Surbotaab/uaefiV2/boards/uaefi-e_/board/misc/uaefi-e_-bottom.png

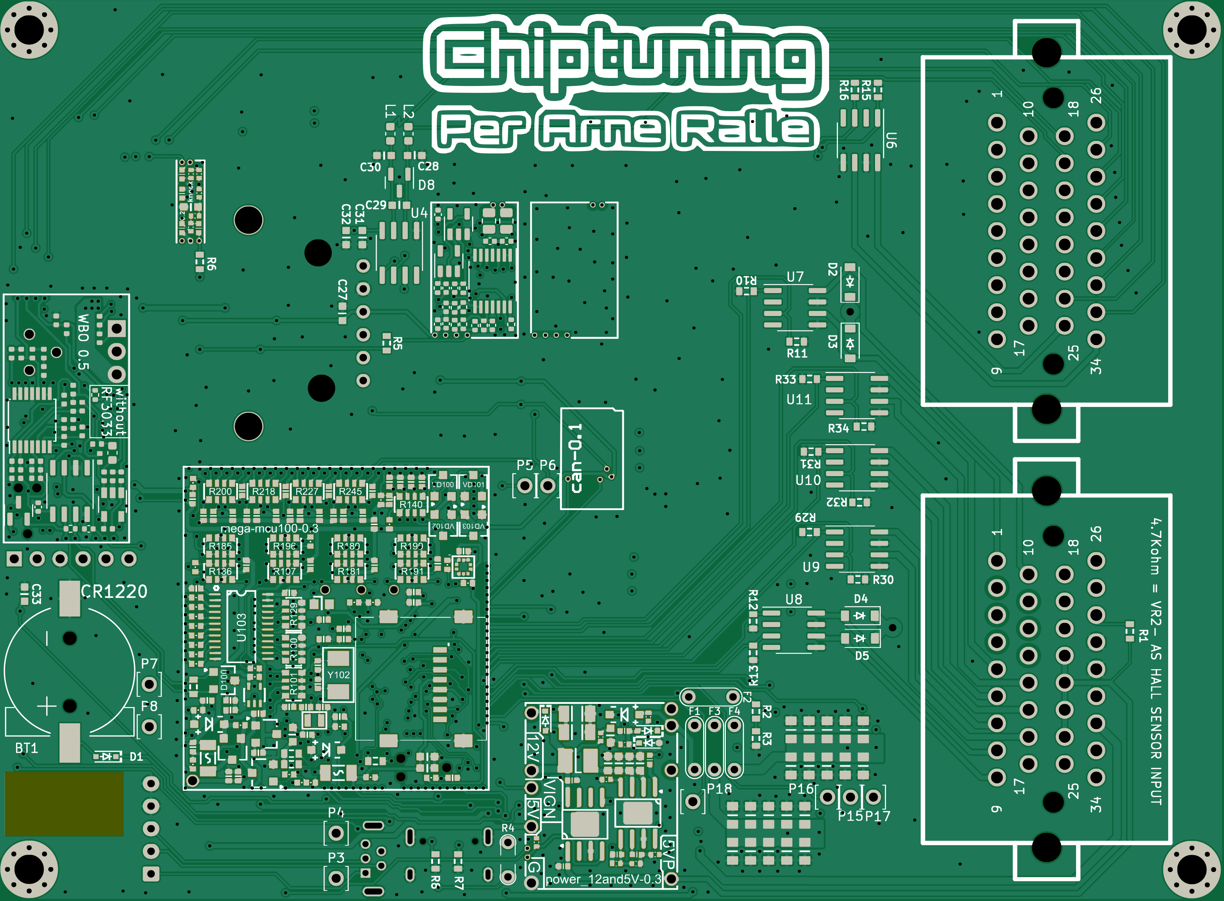
boards/uaefi-e_/board/misc/uaefi-e_-bottom.png
