Surbotaab/uaefiV2/boards/uaefi-e_/board/misc/uaefi-e_-outline.png

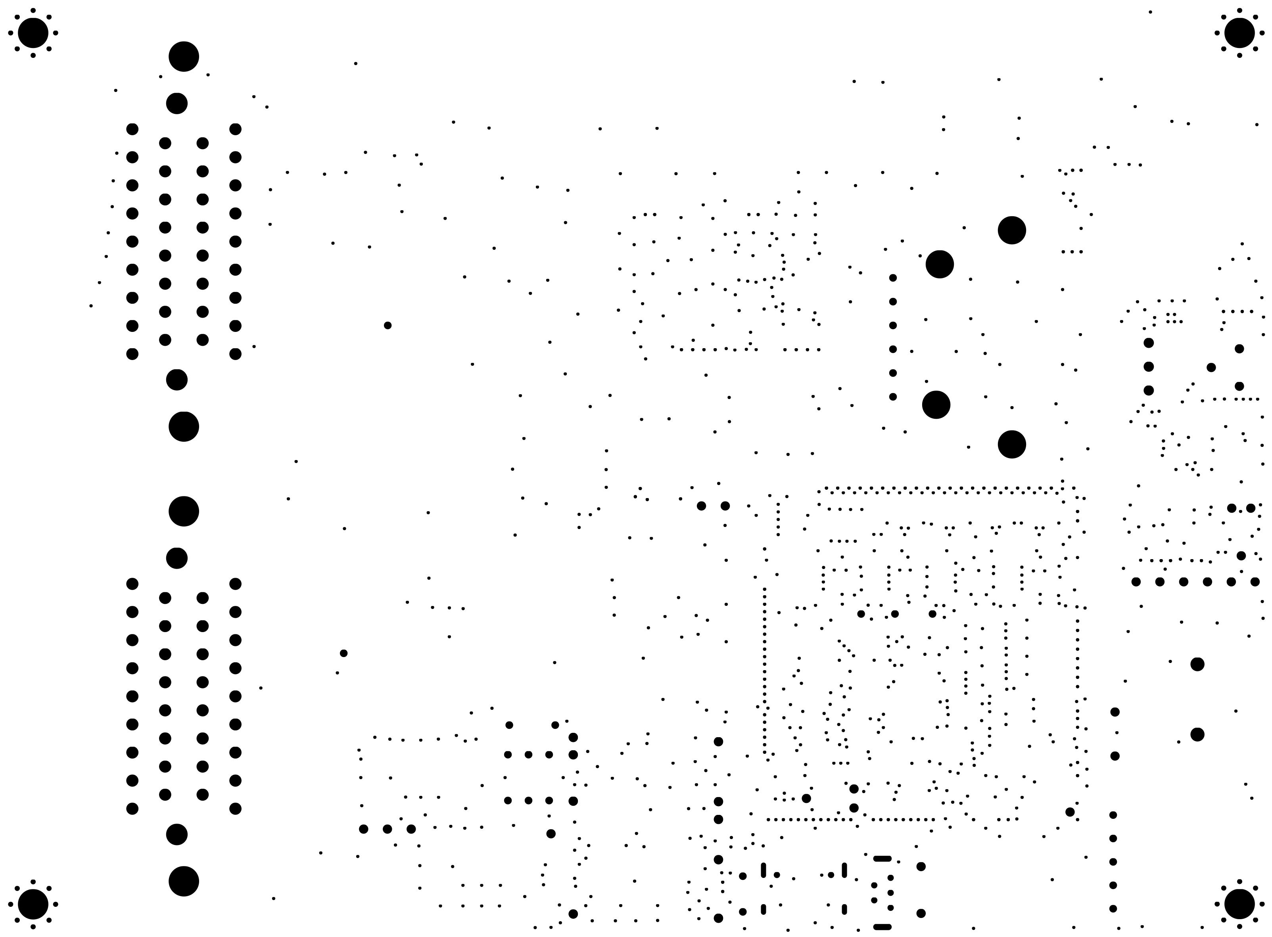
boards/uaefi-e_/board/misc/uaefi-e_-outline.png
