Surbotaab/uaefiV2/boards/uaefi-e_/board/misc/uaefi-e_-top.png

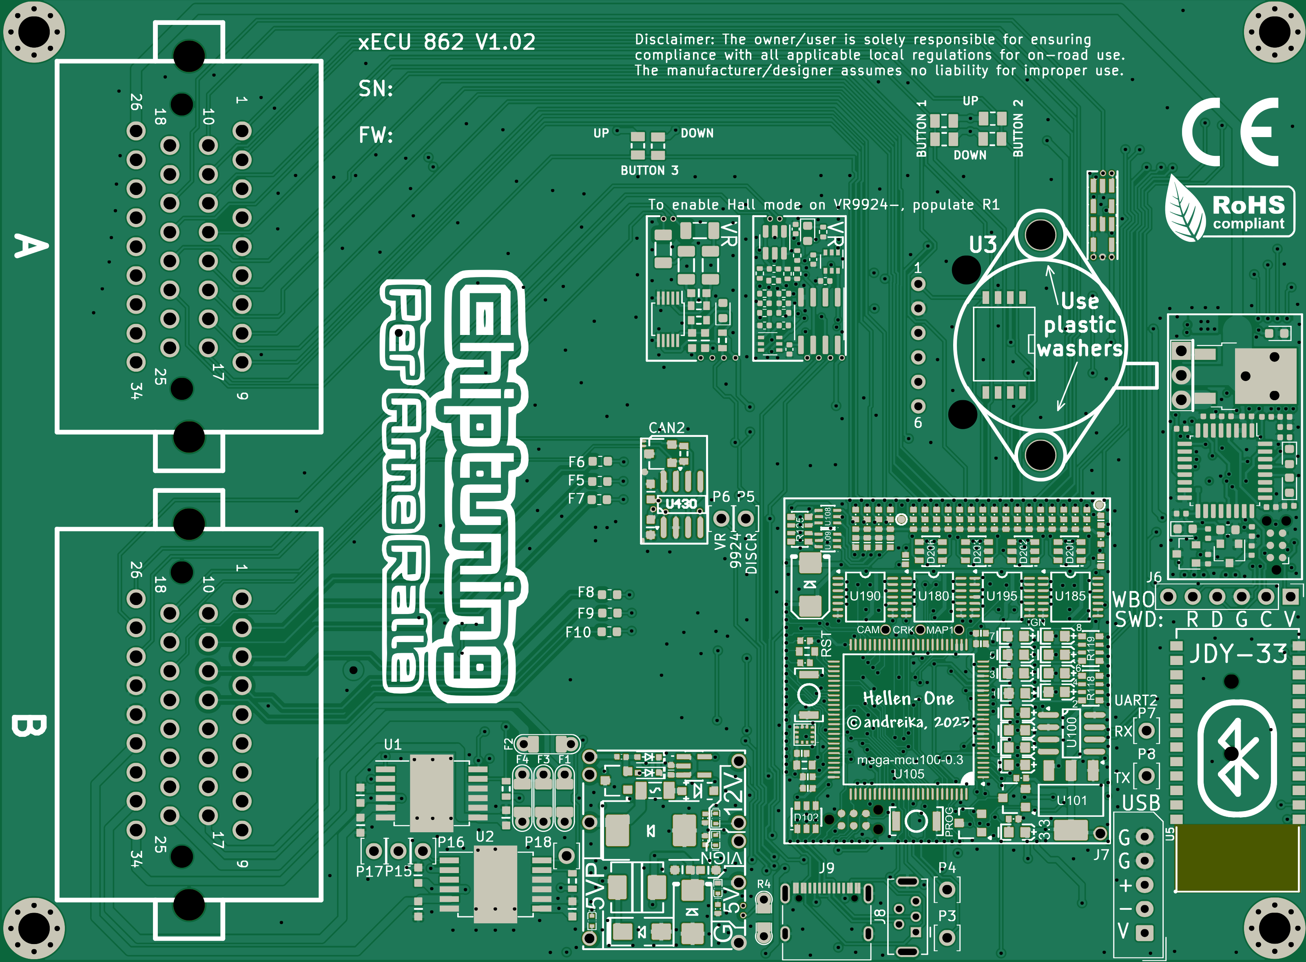
boards/uaefi-e_/board/misc/uaefi-e_-top.png
