Surbotaab/uaefiV2/boards/uaefi-e_/board/uaefi-e_.png

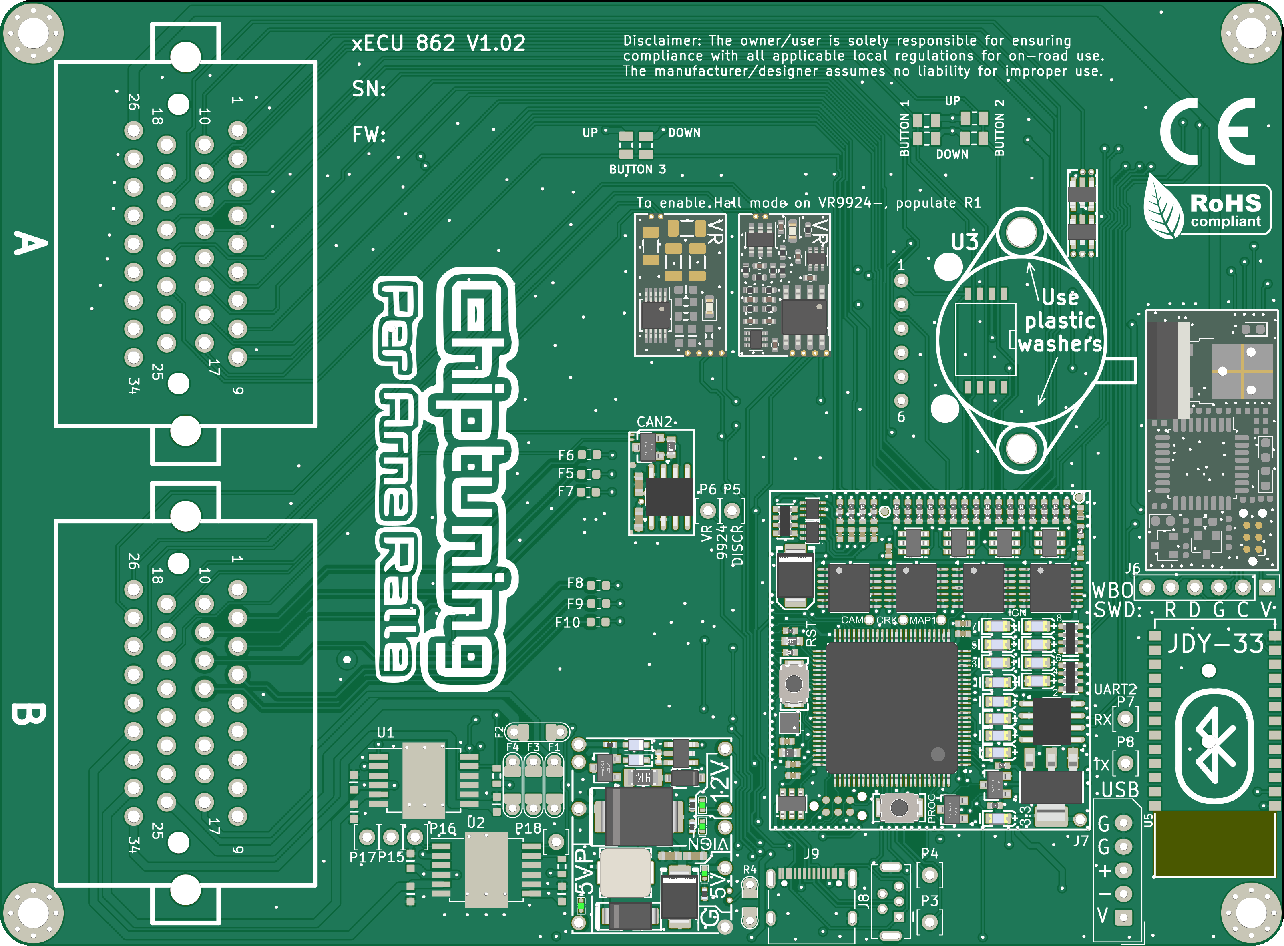
boards/uaefi-e_/board/uaefi-e_.png
