Surbotaab/uaefiV2/boards/uaefi-e_/board/misc/uaefi-e_-components.png

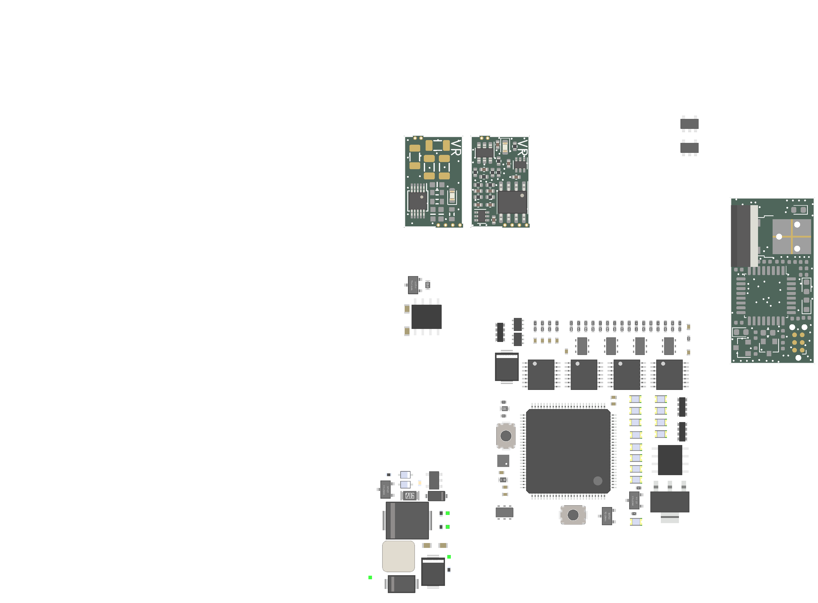
boards/uaefi-e_/board/misc/uaefi-e_-components.png
