Surbotaab/uaefiV2/3D models/2-6447232-3.stp

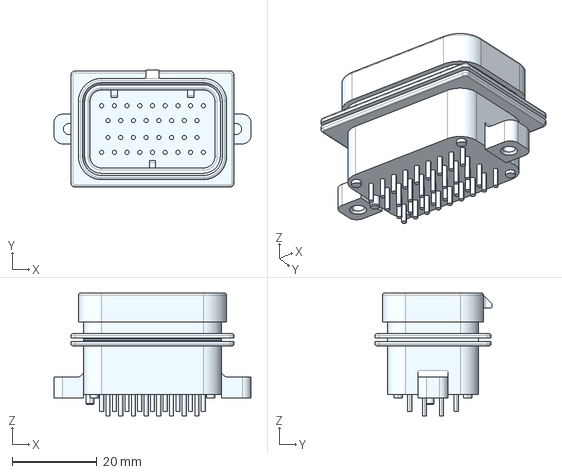
[picture p6: CAD file, 2025-10-13]
3D models/2-6447232-3.stp
46.5 x 27.6 x 29.0 mm
