Surbotaab/uaefiV2/440/uaefiv2.step

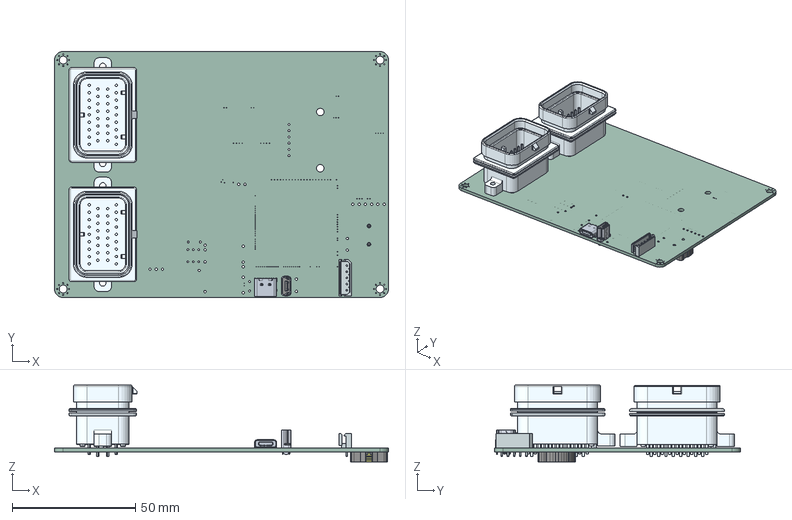
[picture p7: CAD file, 2025-11-03]
440/uaefiv2.step
135.7 x 100.0 x 31.2 mm
C-2-6447232-3 x 2
22035055wbm000_01
B8F5E437-8474-44BC-8B9F-C35146D732A4
u262-16xn-4bvc11_1
CR1220-2
uaefi_PCB
