Surbotaab/uaefiV2/440/changelog.md

# rev E

* power supply fix for RTC
* https://github.com/rusefi/uaefi/issues?q=state%3Aopen%20label%3A%22rev-E%22

# rev D

August 2024

* logic analyzer hookup points for both VRs #66
* minor silkscreen improvements https://github.com/rusefi/uaefi/issues?q=label%3Arev-D+is%3Aclosed

# rev C

Apr 2024

* pad for resistor between VR lines
* a few silkscreen corrections
* full list https://github.com/rusefi/uaefi/issues?q=label%3Arev-C+is%3Aclosed

# rev B

Feb 2024

* [over-current protection on all low side outputs](https://github.com/rusefi/uaefi/issues/44)
* [over-current protection on ignition outputs](https://github.com/rusefi/uaefi/issues/42)
* 0805 button input pull-up/pull-downs added
* button inputs changed from 10K PU to 680K PD https://github.com/rusefi/uaefi/issues/36
* minor cosmetic https://github.com/rusefi/uaefi/labels/rev-B

# rev A

Dec 2023

It works it's great!
