Surbotaab/uaefiV2/uaefi.kicad_pcb

## KiCad design uaefi.kicad_pcb (2026-01-25)

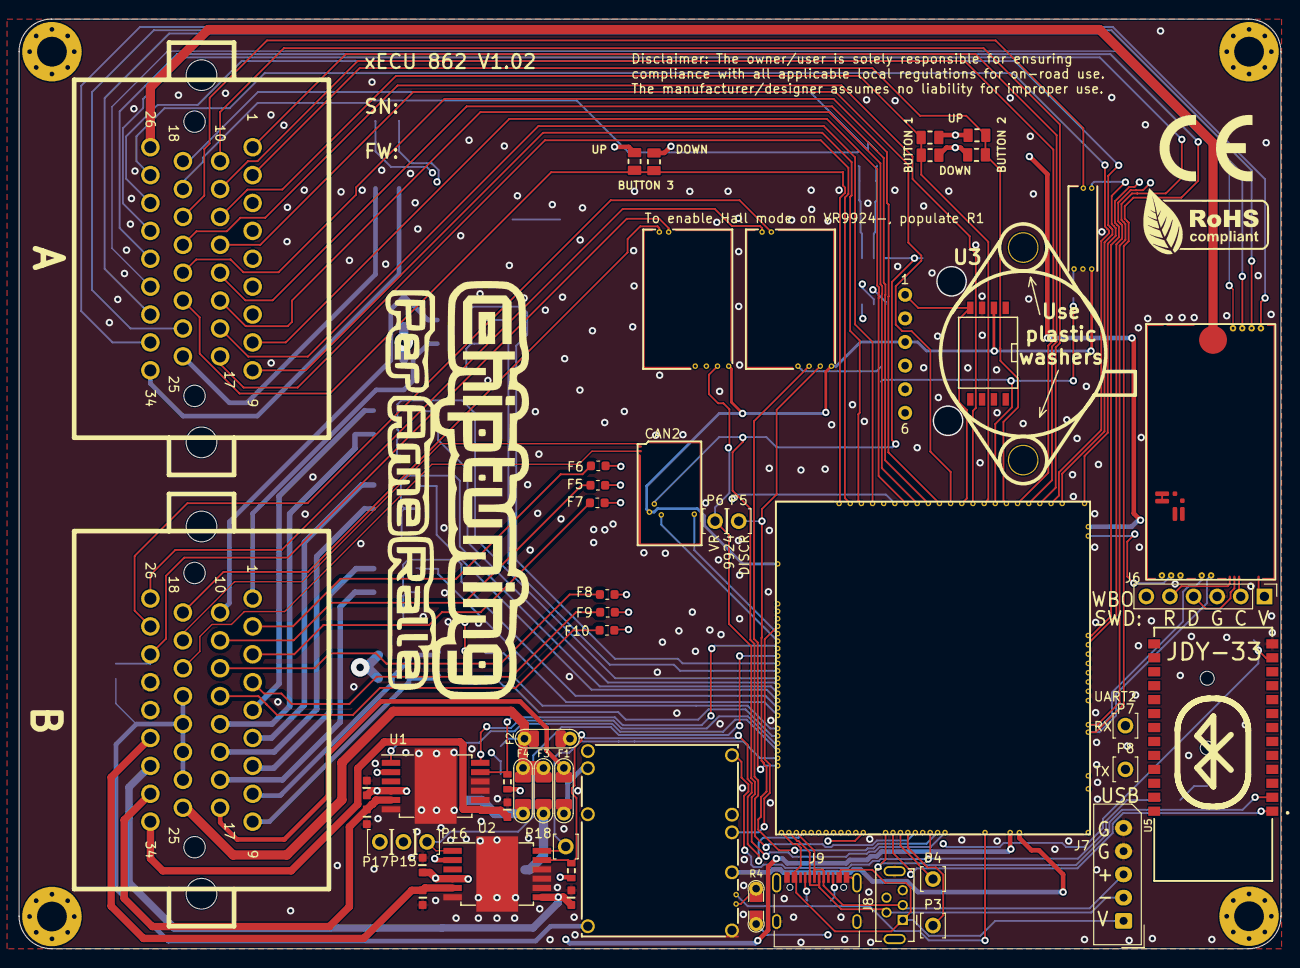
[picture p36: board uaefi.kicad_pcb from above]

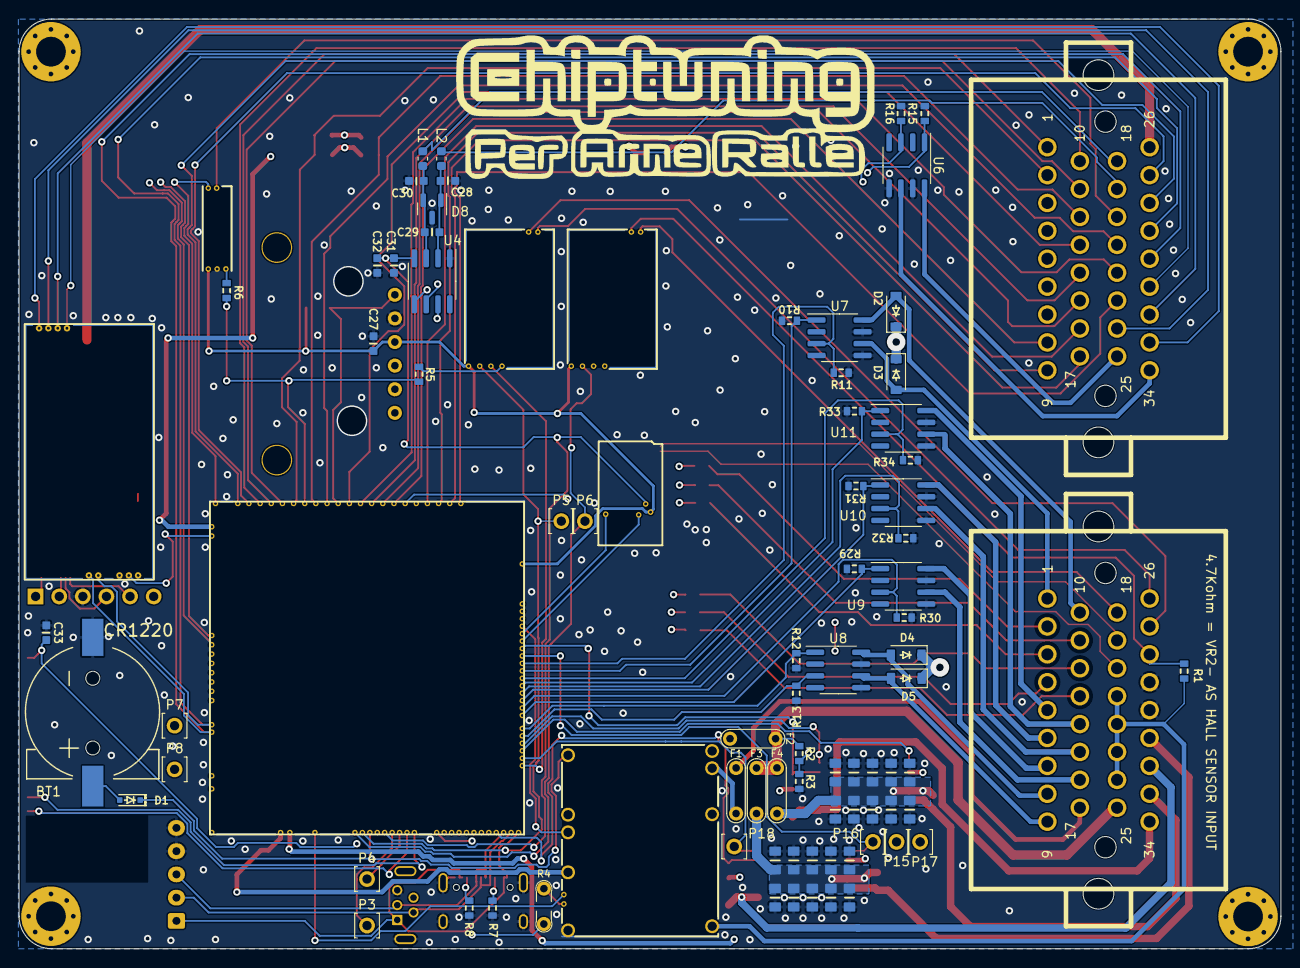
[picture p37: board uaefi.kicad_pcb from below]

Board: 4 copper layers, 135.7 x 100.0 mm, 118 parts (62 on the bottom side), 128 nets.

Parts:
BT1: CR1220; CR1220-2
C1, C2, C3, C4, C5, C6, C7, C8, C9, C10, C14, C15, C16, C17, C18, C19, C20, C21, C22, C23: 10u; C0805
C11, C24, C27, C29, C31, C33: 100n; C0603
C12, C13, C25, C26, C28, C30: 10n; C0603
C32: 1u; C0603
D1: 1N4148WS; SOD-323
D2, D3, D4, D5: B5819W; SOD-123
D8: NUP2105L; SOT-23
F1, F2, F3, F4: 12H1500D; PAD-1206-PAD
F5, F6, F7, F8, F9, F10: 50mA; Fuse_0603_1608Metric
H1, H2, H3, H4: M3; MountingHole_3.2mm_M3_Pad_Via
J6: Conn_01x06; PinHeader_1x06_P2.54mm_Vertical
J7: Conn_01x05_Male; Molex_SPOX_5267-05A_1x05_P2.50mm_Vertical
J8: USB_B_Mini; USB-MINI-B-VERTICAL
J9: USB_C
J23, J25: 2-6447232-3; TE 2-6447232-3
L1, L2: 470R@100MHz; L_0603_1608Metric
M1: Module-power_12and5V-0.3; power_12and5V
M2: Module-knock-0.2; knock
M3: Module-vr-discrete-0.5; vr-discrete
M4: Module-vr-max9924-0.1; vr-max9924
M5: Module-wbo-0.5; wbo
M6: Module:mega-mcu100/0.3; mega-mcu100
M7: Module-can-0.1; can
P3, P4, P5, P6, P7, P8, P15, P16, P17, P18: Pad; PAD-TH
R1, R9, R10, R11, R12, R13, R14, R15, R16, R29, R30, R31, R32, R33, R34: 4.7k; R0603
R2: 33k; R0603
R3: 6.8k; R0603
R4: Jumper-Pad-Pad; PAD-0805-PAD
R5, R6: 0; R0603
R7, R8: 5.6k; R0603
R35, R36, R37: 10k; R0805
R38, R39, R40: DNP; R0805
U1, U2: TLE9201SG; Infineon_PG-DSO-12-11
U3: MPX4/MPXH6400_MAP; MPX-4_MAP
U4: MAX31855KASA; SOIC-8_3.9x4.9mm_P1.27mm
U5: JDY-33
U6, U7, U8, U9, U10, U11: VNLD5160TR-E; SOIC-8_3.9x4.9mm_P1.27mm

Connections:
12V_KEY: F1.1, J23.17
+3.3V: M6.N21 (V33), R9.2, R14.2, U1.2 (VSO), U2.2 (VSO)
+3.3VA: C31.2, C32.2, C33.2, M6.N15 (V33_SWITCHABLE), M7.V2 (CAN_VIO), U4.4 (V_CC), U5.12 (3V3)
+5V: M1.E4 (V5), M6.N22 (VCC)
+5VA: C27.2, M2.E1 (V5A), M3.E4 (V5_IN), M4.E4 (V5_IN), M5.W1 (V5_IN), M6.E1 (V5A_SWITCHABLE), M6.W2 (V5A_SWITCHABLE), M7.V1 (V5), R38.2, R39.2, R40.2, U3.3 (VCC)
+5VP: J23.21, J23.22, J23.23, J23.24, M1.V4 (5VP), R1.1
+12V: F2.1, F3.1, F4.1, J23.25, R2.2
+12V_RAW: D2.1 (K), D3.1 (K), D4.1 (K), D5.1 (K), F2.2, M1.V1 (V12_PERM), M1.V3 (V12_RAW)
/ADC3: M6.S15 (IN_KNOCK_(PA2)), R5.2, R6.2
/CAN+: J25.29, M5.W4 (CANH), M6.W11 (CANH)
/CAN-: J25.30, M5.W3 (CANL), M6.W12 (CANL)
/DC1_DIR: M6.E21 (OUT_PWM4_(PC8)), P15.1, U1.1 (DIR)
/DC1_DIS: M6.E8 (SPI2_MISO_(PB14)), R9.1, U1.11 (DIS)
/DC1_PWM: M6.E20 (OUT_PWM3_(PC7)), P17.1, U1.12 (PWM)
/DC2_DIR: M6.E9 (SPI2_MOSI_(PB15)), P16.1, U2.1 (DIR)
/DC2_DIS: M6.N4 (USBID_(PA10)), R14.1, U2.11 (DIS)
/DC2_PWM: M6.E22 (OUT_PWM5_(PC9)), P18.1, U2.12 (PWM)
/DC Driver 1/PWR: C1.2, C2.2, C3.2, C4.2, C5.2, C6.2, C7.2, C8.2, C9.2, C10.2, C11.2, F4.2, U1.4 (VS)
/DC Driver 2/PWR: C14.2, C15.2, C16.2, C17.2, C18.2, C19.2, C20.2, C21.2, C22.2, C23.2, C24.2, F3.2, U2.4 (VS)
/EGT+: J25.18, L1.1
/EGT-: J25.19, L2.1
/EGT/SPI_CS: M6.N9 (SPI3_CS_(PA15)), U4.6 (~CS)
/IGN1: F6.2, M6.W10 (IGN1_(PC13))
/IGN2: F5.2, M6.W9 (IGN2_(PE5))
/IGN3: F7.2, M6.W8 (IGN3_(PE4))
/IGN4: F8.2, M6.W7 (IGN4_(PE3))
/IGN5: F9.2, M6.W6 (IGN5_(PE2))
/IGN6: F10.2, M6.W5 (IGN6_(PB8))
/INJ1: M6.E17 (OUT_INJ1_(PD3)), R29.2, U9.1 (IN1)
/INJ2: M6.E16 (OUT_INJ2_(PA9)), R30.2, U9.3 (IN2)
/INJ3: M6.E15 (OUT_INJ3_(PD11)), R31.2, U10.1 (IN1)
/INJ4: M6.E14 (OUT_INJ4_(PD10)), R32.2, U10.3 (IN2)
/INJ5: M6.E13 (OUT_INJ5_(PD2)), R33.2, U11.1 (IN1)
/INJ6: M6.E12 (OUT_INJ6_(PA8)), R34.2, U11.3 (IN2)
/INTERNAL_MAP: M6.S12 (IN_MAP2_(PC1)), U3.1 (VOUT)
/IN_AUX1: J25.13, M6.S11 (IN_O2S_/_CAN_WAKEUP_(PA0))
/IN_AUX2: J25.22, M6.S10 (IN_O2S2_(PA1))
/IN_AUX3: J25.8, M6.S7 (IN_AUX3_(PA7))
/IN_BUTTON1: J25.12, M6.S14 (IN_CRANK_(PB1)), R35.2, R38.1
/IN_BUTTON2: J25.2, M6.S16 (IN_CAM_(PA6)), R36.2, R39.1
/IN_BUTTON3: J25.23, M6.S1 (IN_D4_(PE15)), R37.2, R40.1
/IN_CLT: J25.28, M6.S21 (IN_CLT_(PC2))
/IN_FLEX: J25.11, M6.S17 (IN_VSS_(PE11))
/IN_HALL1: J25.16, M6.S4 (IN_D1_(PE12))
/IN_HALL2: J25.9, M6.S3 (IN_D2_(PE13))
/IN_HALL3: J25.17, M6.S2 (IN_D3_(PE14))
/IN_IAT: J25.27, M6.S20 (IN_IAT_(PC3))
/IN_KNOCK: M2.E3 (OUT_KNOCK), R6.1
/IN_KNOCK_RAW: J25.20, M2.W1 (IN_KNOCK)
/IN_PPS1: J25.10, M6.S19 (IN_PPS_(PA3))
/IN_PPS2: J25.15, M6.S8 (IN_AUX2_(PC4/PE9))
/IN_TPS1: J25.1, M6.S18 (IN_TPS_(PA4))
/IN_TPS2: J25.14, M6.S9 (IN_AUX1_(PB0))
/IN_VIGN: F1.2, M1.V2 (IN_VIGN)
/IN_VMAIN: M6.S6 (IN_AUX4_(PC5)), R2.1, R3.2
/LS1: M6.E11 (OUT_INJ7_(PD15)), R10.2, U7.1 (IN1)
/LS2: M6.E10 (OUT_INJ8_(PD12)), R11.2, U7.3 (IN2)
/LS3: M6.E18 (OUT_PWM1_(PD13)), R12.2, U8.1 (IN1)
/LS4: M6.E19 (OUT_PWM2_(PC6)), R13.2, U8.3 (IN2)
/LS_HOT1: M6.W4 (IGN7_(PB9)), R16.1, U6.3 (IN2)
/LS_HOT2: M6.W3 (IGN8_(PE6)), R15.1, U6.1 (IN1)
/MISO3: M6.N11 (SPI3_MISO_(PC11)), U4.7 (SO)
/OUT_DC1+: C13.2, J23.34, U1.7 (OUT2)
/OUT_DC1-: C12.2, J23.33, U1.5 (OUT1)
/OUT_DC2+: C26.2, J23.32, U2.7 (OUT2)
/OUT_DC2-: C25.2, J23.31, U2.5 (OUT1)
/OUT_IGN1: F6.1, J23.2
/OUT_IGN2: F5.1, J23.11
/OUT_IGN3: F7.1, J23.3
/OUT_IGN4: F8.1, J23.12
/OUT_IGN5: F9.1, J23.4
/OUT_IGN6: F10.1, J23.13
/OUT_INJ1: J23.7, U9.8 (D1)
/OUT_INJ2: J23.16, U9.6 (D2)
/OUT_INJ3: J23.6, U10.8 (D1)
/OUT_INJ4: J23.15, U10.6 (D2)
/OUT_INJ5: J23.5, U11.8 (D1)
/OUT_INJ6: J23.14, U11.6 (D2)
/OUT_LS1: D2.2 (A), J23.10, U7.8 (D1)
/OUT_LS2: D3.2 (A), J23.1, U7.6 (D2)
/OUT_LS3: D4.2 (A), J23.8, U8.8 (D1)
/OUT_LS4: D5.2 (A), J23.9, U8.6 (D2)
/OUT_LS_HOT1: J25.34, U6.6 (D2)
/OUT_LS_HOT2: J25.25, U6.8 (D1)
/PG_5VP: M6.N12 (SPI3_MOSI_(PC12)), R4.2
/PWR_EN: M1.E5 (EN_5VP), M6.N20 (OUT_PWR_EN_(PE10))
/SCK3: M6.N10 (SPI3_SCK_(PC10)), U4.5 (SCK)
/USB+: J7.3, J8.3 (D+), J9.A6 (D+), J9.B6 (D+), M6.N3 (USBP_(PA12))
/USB-: J7.2, J8.2 (D-), J9.A7 (D-), J9.B7 (D-), M6.N2 (USBM_(PA11))
/VBAT: D1.1 (K), M1.E1 (VBAT), M6.N17 (VBAT)
/VBUS: J7.1, J8.1 (VBUS), J9.A4 (VBUS), J9.A9 (VBUS), J9.B4 (VBUS), J9.B9 (VBUS), M6.N1 (VBUS)
/VIGN: M1.E3 (VIGN), M6.E5 (IN_VIGN_(PA5))
/VREF1: M2.W2 (VREF), M6.S22 (VREF1)
/VR_DISCRETE: M3.E3 (OUT), M6.N18 (UART8_RX_(PE0)), P5.1
/VR_DISCRETE+: J23.26, M3.W2 (VR+)
/VR_DISCRETE-: J23.27, M3.W1 (VR-)
/VR_DISCRETE_A: M3.E2 (OUT_A), R5.1
/VR_DISCRETE_THR: M3.E1 (Thresh_IN), M6.E23 (OUT_PWM6_(PD14))
/VR_MAX9924: M4.E3 (OUT), M6.N19 (UART8_TX_(PE1)), P6.1
/VR_MAX9924+: J23.18, M4.W2 (VR+)
/VR_MAX9924-: J23.28, M4.W1 (VR-), R1.2
/WBO_Heater: J25.26, M5.E5 (LSU_H+)
/WBO_Ip: J25.32, M5.E3 (LSU_Ip)
/WBO_Rtrim: J25.24, M5.E4 (LSU_Rtrim)
/WBO_Un: J25.33, M5.E1 (LSU_Un)
/WBO_Vm: J25.31, M5.E2 (LSU_Vm)
CAN2H: J23.20, M7.S2 (CANH)
CAN2L: J23.19, M7.S1 (CANL)
GND: BT1.2 (-), C1.1, C2.1, C3.1, C4.1, C5.1, C6.1, C7.1, C8.1, C9.1, C10.1, C11.1, C12.1, C13.1, C14.1, C15.1, C16.1, C17.1, C18.1, C19.1, C20.1, C21.1, C22.1, C23.1, C24.1, C25.1, C26.1, C27.1, C28.1, C30.1, C31.1, C32.1, C33.1, D8.3 (A), J6.3, J7.4, J7.5, J8.5 (GND), J8.6 (Shield), J9.A1 (GND), J9.A12 (GND), J9.B1 (GND), J9.B12 (GND), J9.S1 (SHIELD), J23.29, J23.30, M1.S1 (GND), M2.E2 (GND), M3.G (GND), M4.G (GND), M5.E6 (LSU_H-), M5.G (GND), M6.G (GND), M7.E1 (GND), R3.1, R7.1, R8.1, R10.1, R11.1, R12.1, R13.1, R15.2, R16.2, R29.1, R30.1, R31.1, R32.1, R33.1, R34.1, U1.6 (GND), U1.8 (SI), U1.9 (CSN), U1.10 (SCK), U1.13 (GND), U2.6 (GND), U2.8 (SI), U2.9 (CSN), U2.10 (SCK), U2.13 (GND), U3.2 (GND), U4.1 (GND), U5.13 (GND), U6.5 (S2), U6.7 (S1), U7.5 (S2), U7.7 (S1), U8.5 (S2), U8.7 (S1), U9.5 (S2), U9.7 (S1), U10.5 (S2), U10.7 (S1), U11.5 (S2), U11.7 (S1)
GNDA: J25.3, J25.4, J25.5, J25.6, J25.7, M6.W1 (GNDA), R35.1, R36.1, R37.1
IN_MAP: J25.21, M6.S13 (IN_MAP1_(PC0))
unnamed: BT1.1 (+), D1.2 (A)
unnamed: J6.1, M5.W8 (V33_OUT)
unnamed: J6.2, M5.W7 (SWCLK)
unnamed: J6.4, M5.W6 (SWDIO)
unnamed: J6.5, M5.W5 (nReset)
unnamed: J9.A5 (CC1), R7.2
unnamed: J9.B5 (CC2), R8.2
unnamed: M1.E6 (PG_5VP), R4.1
unnamed: M5.J1 (SEL1), M5.J_GND1 (PULL_DOWN1)
unnamed: M6.N14a (LED_GREEN), P4.1
unnamed: M6.N14b (LED_YELLOW), P3.1
unnamed: M6.E6 (SPI2_CS_/_CAN2_RX_(PB12)), M7.V6 (CAN_RX)
unnamed: M6.E7 (SPI2_SCK_/_CAN2_TX_(PB13)), M7.V5 (CAN_TX)
unnamed: M6.N14 (UART2_RX_(PD6)), P7.1, U5.1 (TXD)
unnamed: M6.N13 (UART2_TX_(PD5)), P8.1, U5.2 (RXD)
unnamed: C29.2, C30.2, D8.2 (K), L1.2, U4.3 (T+)
unnamed: C28.2, C29.1, D8.1 (K), L2.2, U4.2 (T-)
