Surbotaab/uaefiV2/(commit log)

2025-10-13 a
    c
    [2-6447232-3.stp, DC_MOTOR_0.1.kicad_sch, IGN6.kicad_sch, INJ6.kicad_sch, LS4.kicad_sch, LS_HOT.kicad_sch, MAP.kicad_sch, egt.kicad_sch]
2025-10-13 s
    df
    [uaefi.kicad_pcb]
2025-10-13 [skip actions] Auto-generated board v2.1
    [uaefi-B_Cu.gbl, uaefi-B_Mask.gbs, uaefi-B_Paste.gbp, uaefi-B_Silkscreen.gbo, uaefi-Edge_Cuts.gm1, uaefi-F_Cu.gtl, uaefi-F_Mask.gts, uaefi-F_Paste.gtp]
2025-10-13 AAa
    AA
    [bom_replace_uaefi-e_.csv, uaefi.kicad_pcb]
2025-10-13 mkn
    mnj
    [uaefi.kicad_pcb]
2025-10-24 A
    AAA
    [uaefi.kicad_pcb, uaefi.kicad_sch]
2025-11-03 Final marking
    [uaefi.kicad_pcb]
2025-11-05 Prod Candidate 1
    [uaefi.kicad_pcb]
2026-01-21 a
    b
    [440.kicad_pcb, 440.kicad_sch, DC_MOTOR_0.1.kicad_sch, IGN6.kicad_sch, INJ6.kicad_sch, LS4.kicad_sch, LS_HOT.kicad_sch, MAP.kicad_sch]
2026-01-21 a
    A
    [uaefi.kicad_pcb]
